SMGStudiosLLC/ASL-Wiz/renders/04_front_elevation.png

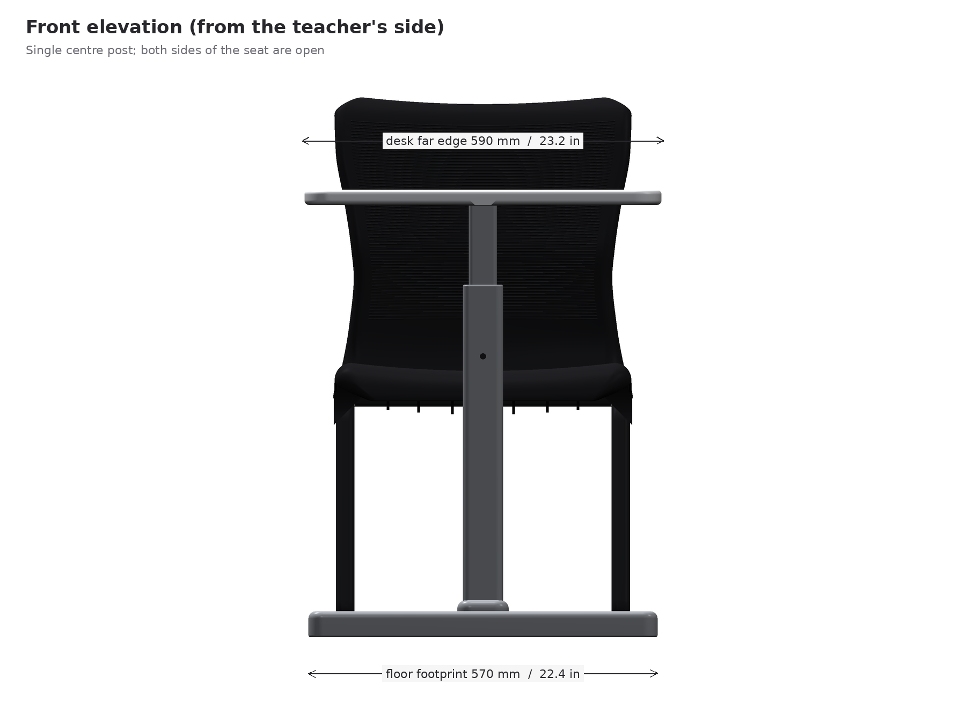
renders/04_front_elevation.png
