SMGStudiosLLC/ASL-Wiz/models/DELTA_chair-desk_full-size.step

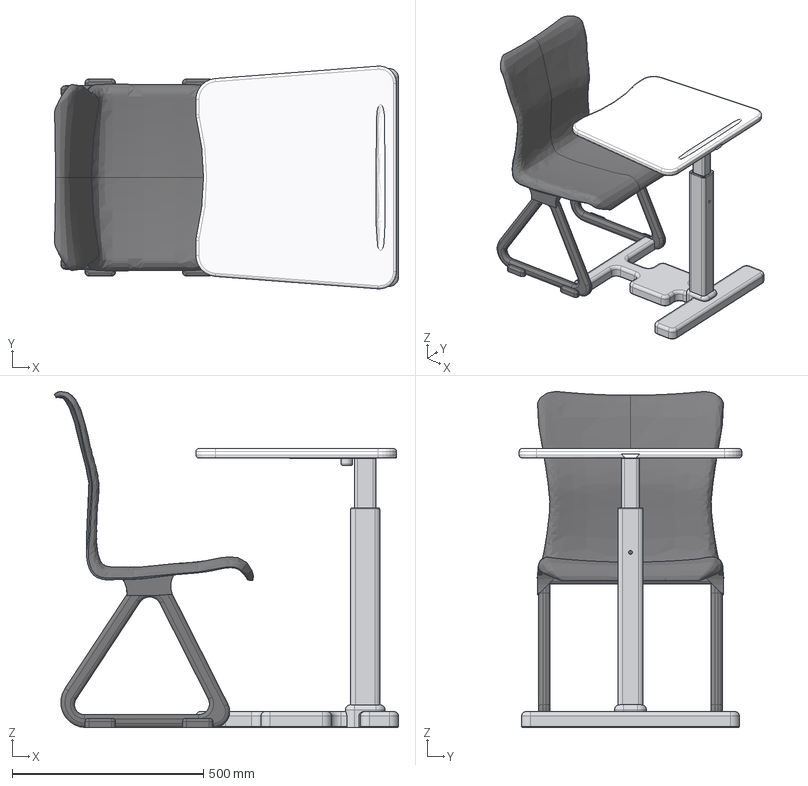
[picture p11: CAD file, 2026-09-27]
models/DELTA_chair-desk_full-size.step
899.8 x 582.6 x 879.4 mm
seat_shell
seat_beam
frame_left
frame_right
floor_base
post_lower_sleeve
post_upper_head
desktop
track_end_plug
