SMGStudiosLLC/ASL-Wiz/models/stl/seat_beam_full-size_mm.stl

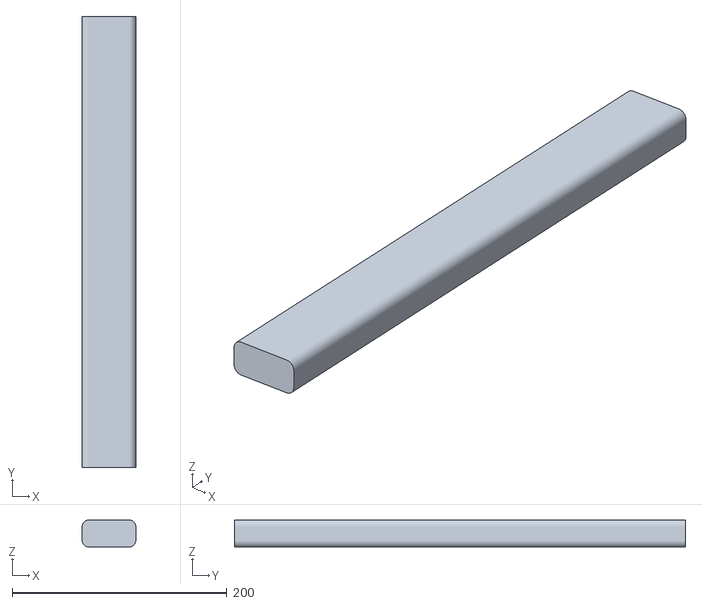
[picture p12: CAD file, 2026-09-27]
models/stl/seat_beam_full-size_mm.stl
50.0 x 420.0 x 25.0
