SMGStudiosLLC/ASL-Wiz/print/DELTA_1-6_assembled_preview.3mf

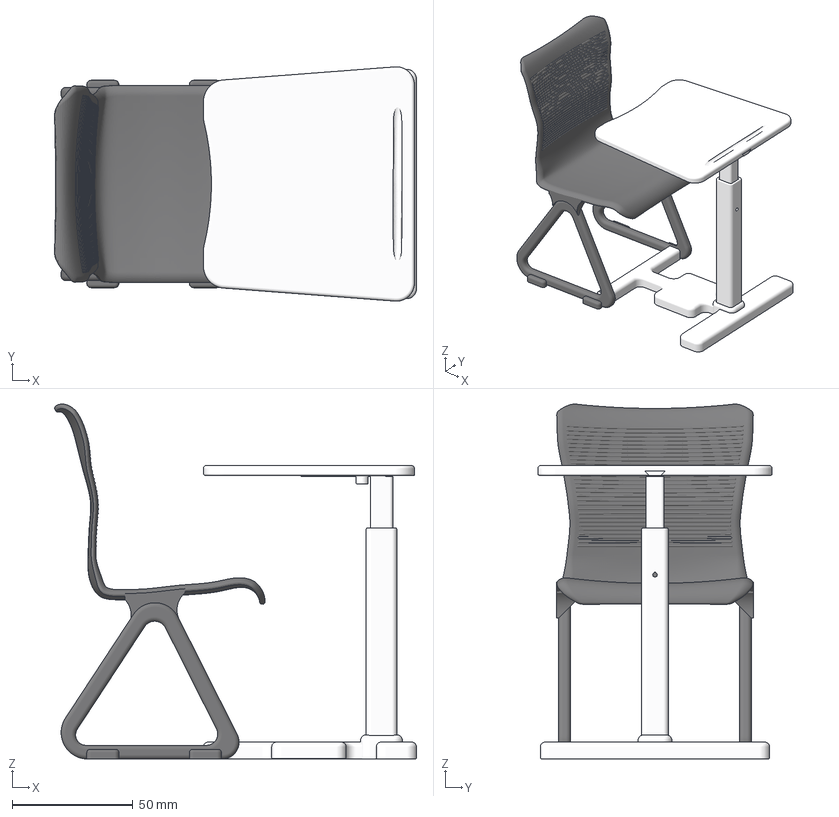
[picture p13: CAD file, 2026-09-27]
print/DELTA_1-6_assembled_preview.3mf
150.0 x 97.1 x 147.1 mm
seat_shell
frame_left
frame_right
floor_base
post_lower_sleeve
post_upper_head
desktop
track_end_plug
