SMGStudiosLLC/ASL-Wiz/models/stl/frame_right_full-size_mm.stl

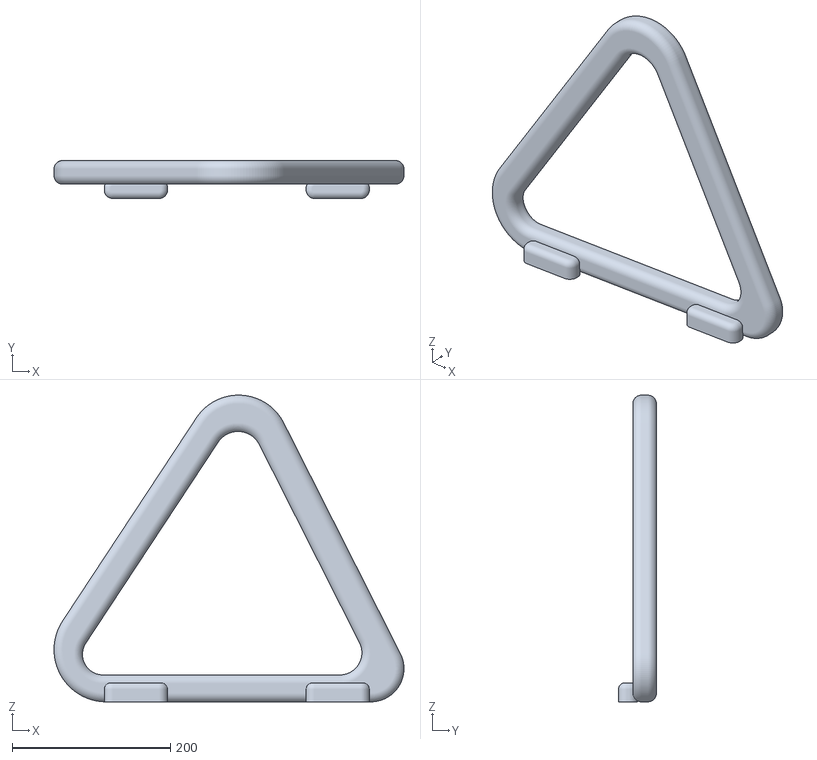
[picture p14: CAD file, 2026-09-27]
models/stl/frame_right_full-size_mm.stl
442.2 x 48.0 x 387.5
