SMGStudiosLLC/ASL-Wiz/models/stl/seat_shell_full-size_mm.stl

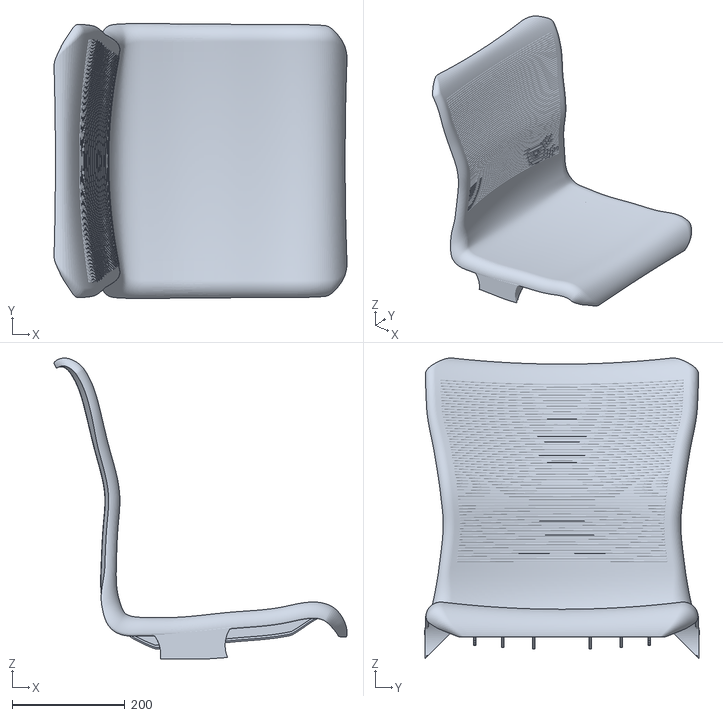
[picture p15: CAD file, 2026-09-27]
models/stl/seat_shell_full-size_mm.stl
520.4 x 489.0 x 534.4
