SMGStudiosLLC/ASL-Wiz/models/stl/desktop_full-size_mm.stl

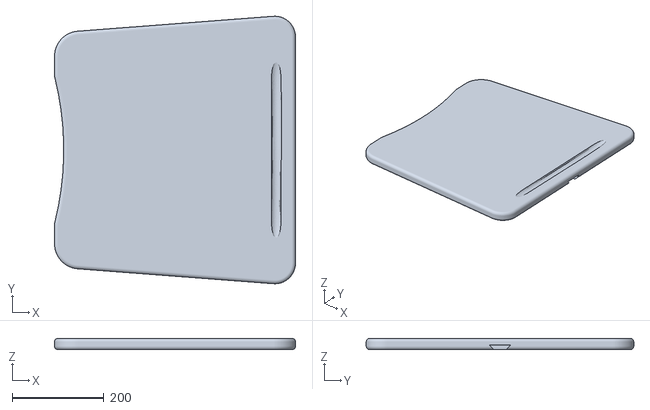
[picture p16: CAD file, 2026-09-27]
models/stl/desktop_full-size_mm.stl
525.0 x 582.9 x 25.0
