SMGStudiosLLC/ASL-Wiz/models/stl/track_end_plug_full-size_mm.stl

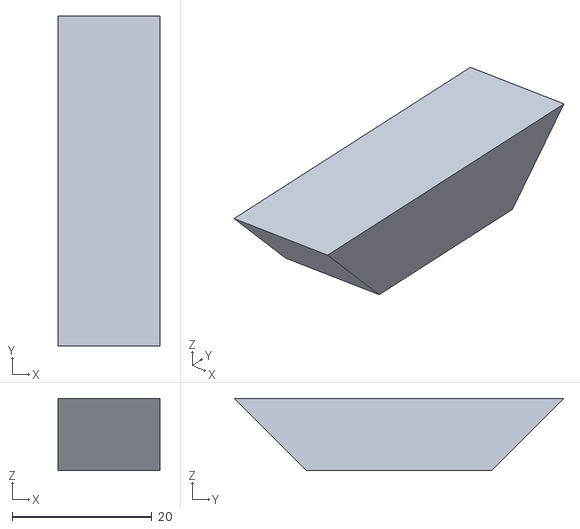
[picture p17: CAD file, 2026-09-27]
models/stl/track_end_plug_full-size_mm.stl
14.6 x 47.2 x 10.3
