SMGStudiosLLC/ASL-Wiz/models/stl/floor_base_full-size_mm.stl

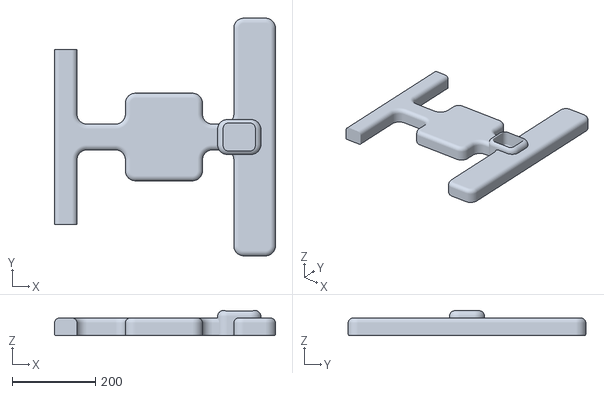
[picture p18: CAD file, 2026-09-27]
models/stl/floor_base_full-size_mm.stl
530.0 x 570.0 x 60.0
