SMGStudiosLLC/ASL-Wiz/models/stl/post_lower_sleeve_full-size_mm.stl

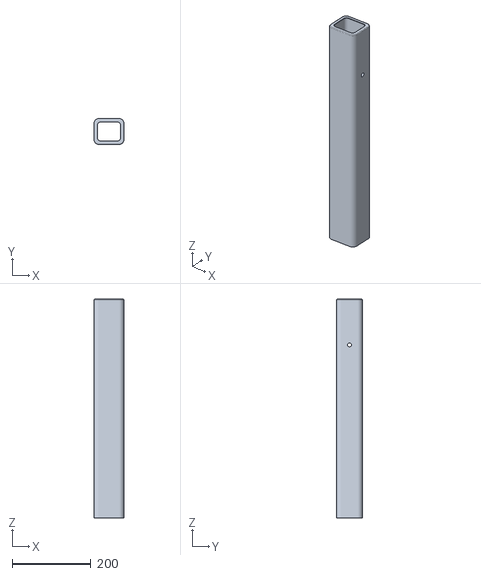
[picture p19: CAD file, 2026-09-27]
models/stl/post_lower_sleeve_full-size_mm.stl
76.0 x 66.0 x 558.0
