SMGStudiosLLC/ASL-Wiz/models/stl/post_upper_head_full-size_mm.stl

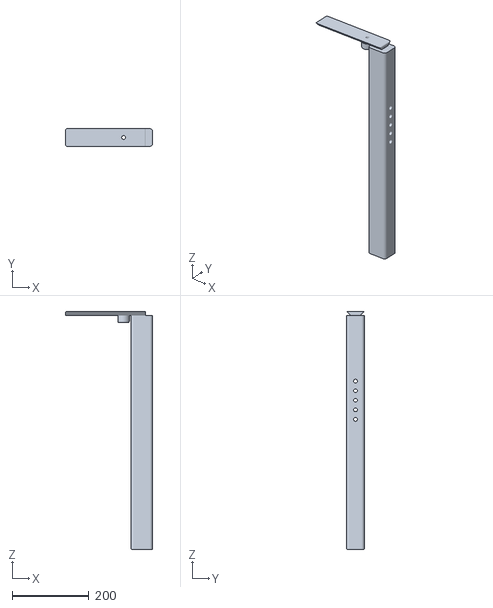
[picture p20: CAD file, 2026-09-27]
models/stl/post_upper_head_full-size_mm.stl
228.0 x 46.0 x 622.0
