SMGStudiosLLC/ASL-Wiz/print/stl/08_track_end_plug_WHITE.stl

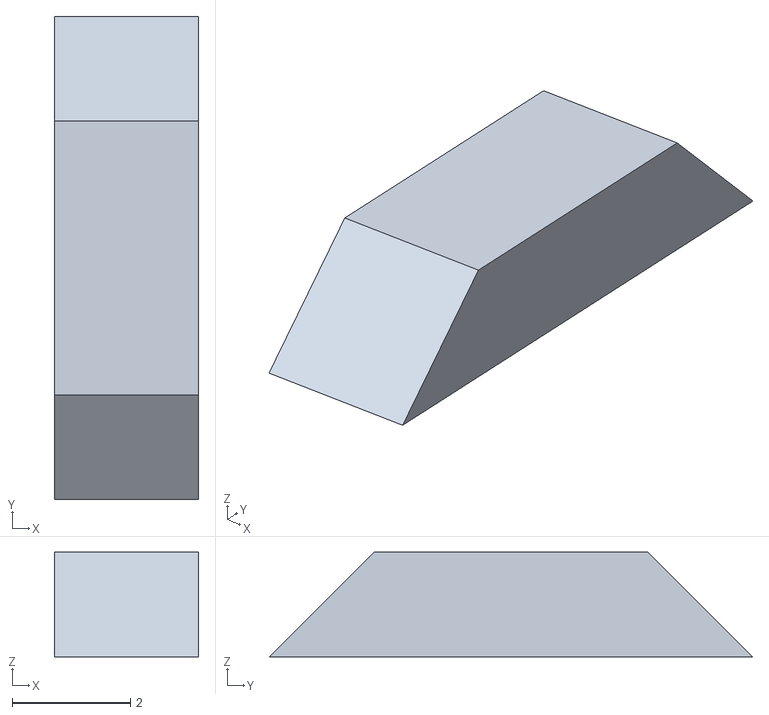
[picture p21: CAD file, 2026-09-27]
print/stl/08_track_end_plug_WHITE.stl
2.43 x 8.17 x 1.77
