SMGStudiosLLC/ASL-Wiz/print/DELTA_1-6_WHITE_plate.3mf

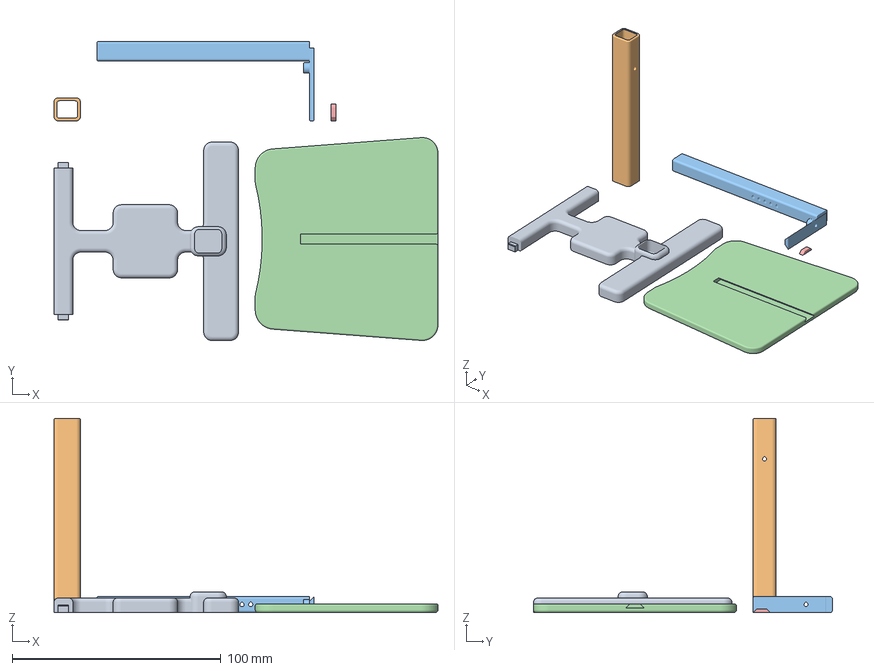
[picture p22: CAD file, 2026-09-27]
print/DELTA_1-6_WHITE_plate.3mf
183.8 x 143.1 x 93.0 mm
floor_base
post_lower_sleeve
post_upper_head
desktop
track_end_plug
