SMGStudiosLLC/ASL-Wiz/print/stl/06_post_upper_head_WHITE.stl

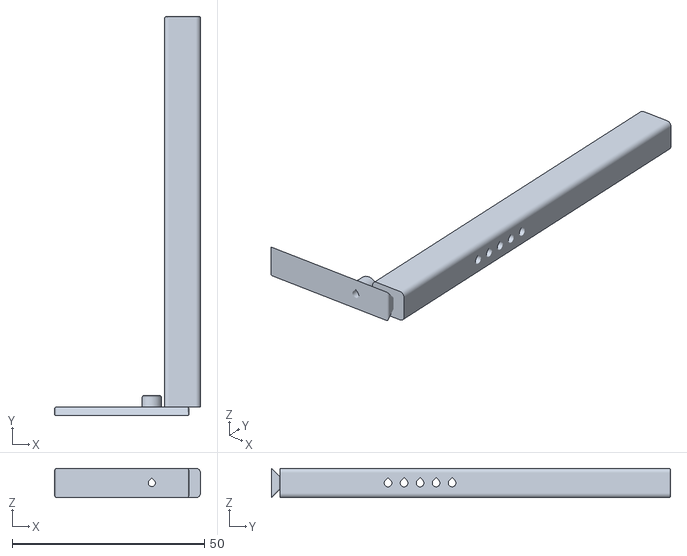
[picture p23: CAD file, 2026-09-27]
print/stl/06_post_upper_head_WHITE.stl
38.0 x 103.8 x 7.67
