SMGStudiosLLC/ASL-Wiz/print/DELTA_1-6_BLACK_plate.3mf

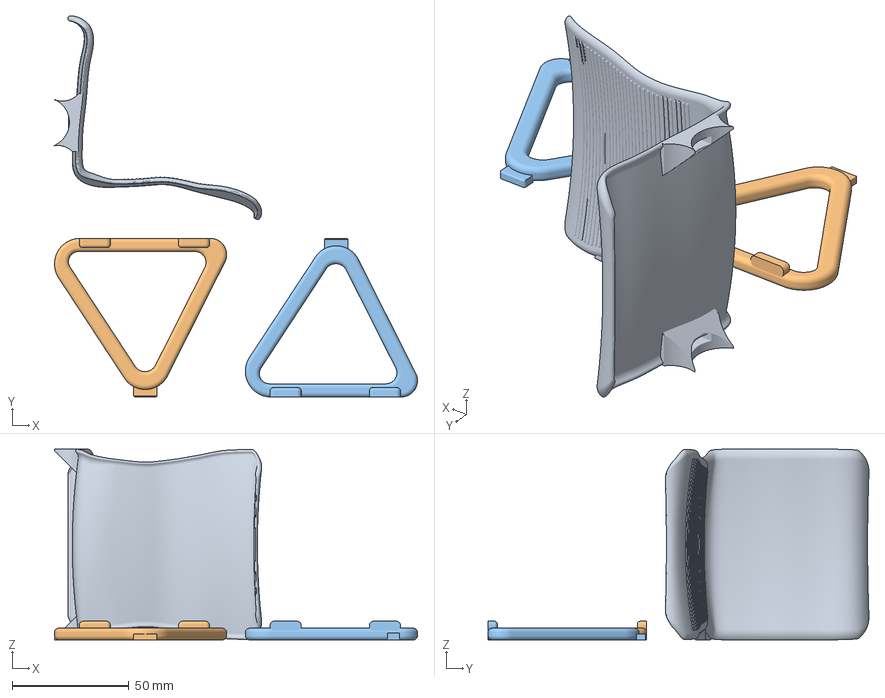
[picture p24: CAD file, 2026-09-27]
print/DELTA_1-6_BLACK_plate.3mf
155.5 x 163.2 x 81.7 mm
seat_shell
frame_left
frame_right
