SMGStudiosLLC/ASL-Wiz/print/stl/07_desktop_WHITE.stl

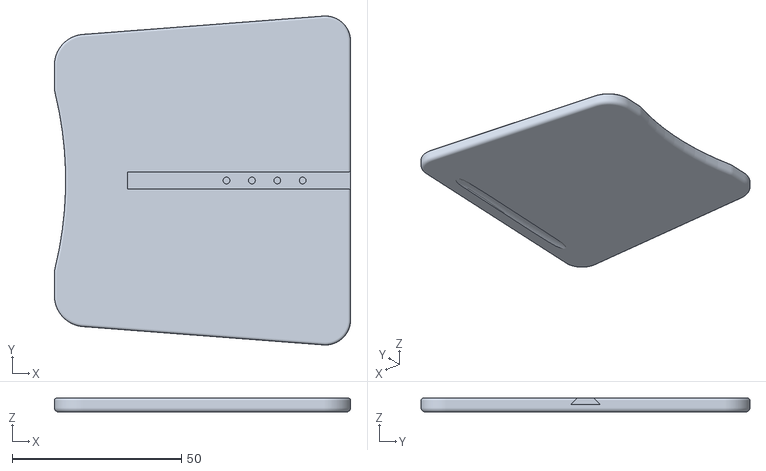
[picture p25: CAD file, 2026-09-27]
print/stl/07_desktop_WHITE.stl
87.5 x 97.1 x 4.17
