SMGStudiosLLC/ASL-Wiz/print/stl/04_floor_base_WHITE.stl

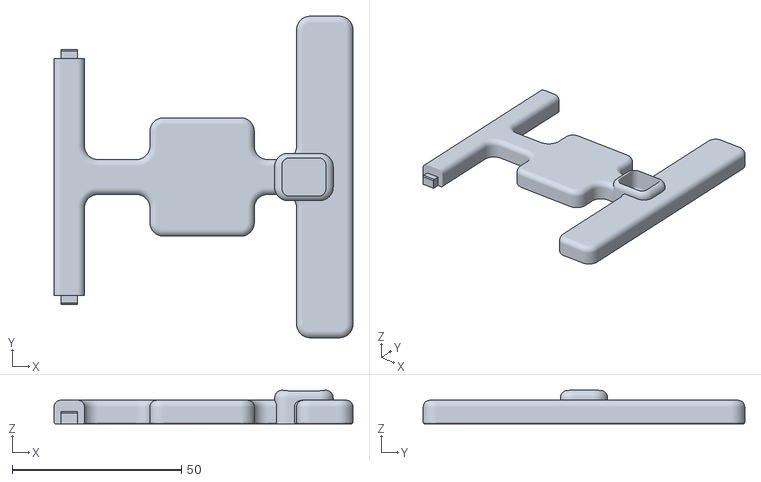
[picture p26: CAD file, 2026-09-27]
print/stl/04_floor_base_WHITE.stl
88.3 x 95.0 x 10.00
