SMGStudiosLLC/ASL-Wiz/print/stl/03_frame_right_BLACK.stl

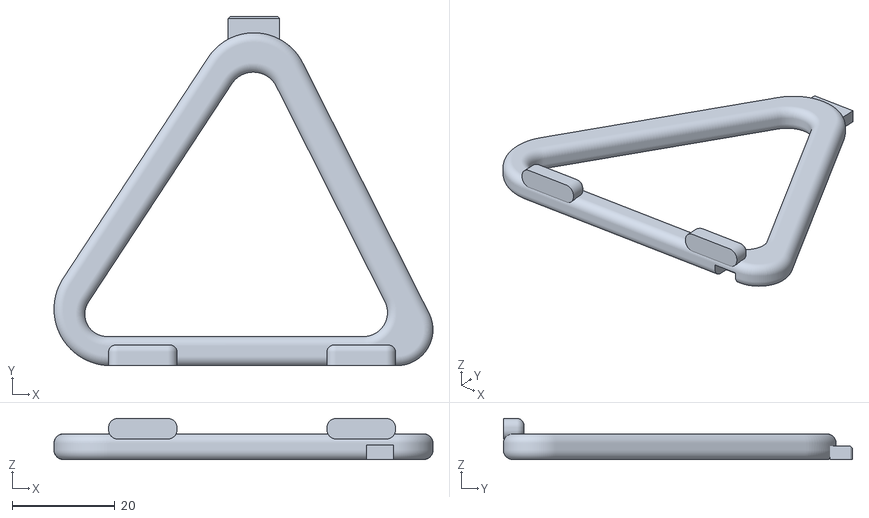
[picture p27: CAD file, 2026-09-27]
print/stl/03_frame_right_BLACK.stl
73.7 x 68.0 x 8.00
