SMGStudiosLLC/ASL-Wiz/print/stl/01_seat_shell_BLACK.stl

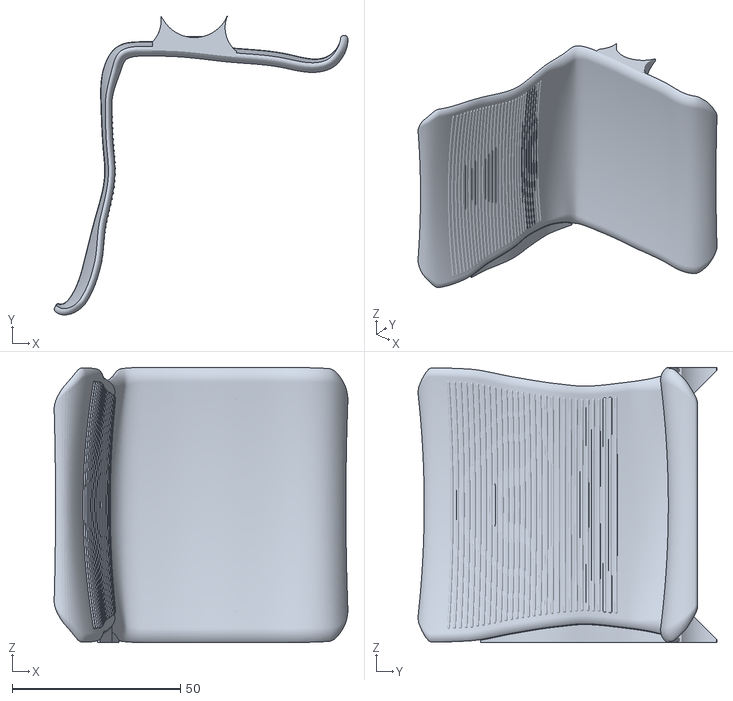
[picture p28: CAD file, 2026-09-27]
print/stl/01_seat_shell_BLACK.stl
87.2 x 88.8 x 81.7
