SMGStudiosLLC/ASL-Wiz/print/stl/05_post_lower_sleeve_WHITE.stl

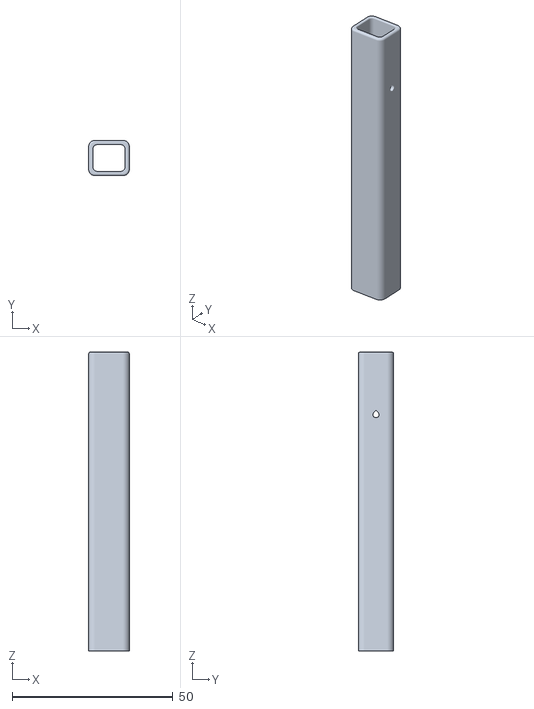
[picture p29: CAD file, 2026-09-27]
print/stl/05_post_lower_sleeve_WHITE.stl
12.7 x 11.0 x 93.0
