SMGStudiosLLC/ASL-Wiz/(list of files, cad)

Other CAD files:
models/stl/frame_left_full-size_mm.stl
print/stl/02_frame_left_BLACK.stl
