SMGStudiosLLC/ASL-Wiz/renders/11_print_plates.png

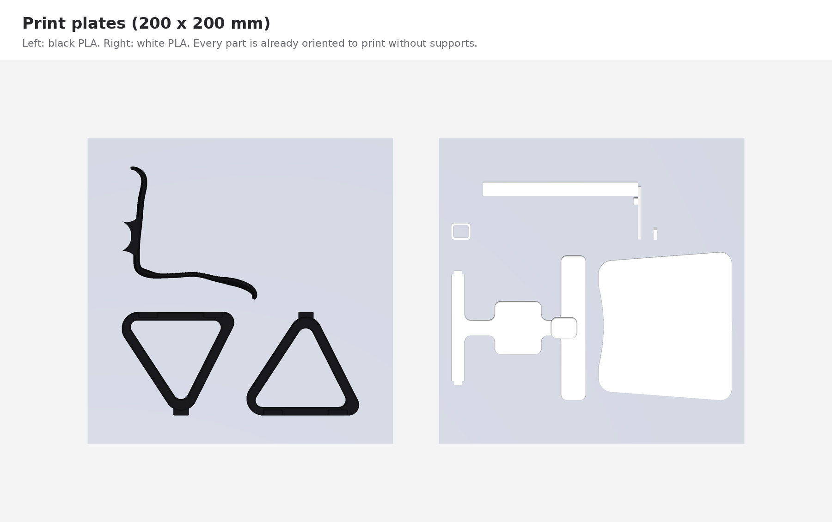
renders/11_print_plates.png
