SMGStudiosLLC/ASL-Wiz/docs/VERIFICATION.md

# Verification report

Generated by `cad/verify_all.py` on 2026-09-27. Every number below is computed from the same geometry that produced the print files.

## 1. Print kit (1:6)

| part | watertight | print size (mm) | solid PLA | bed contact (mm2) | 5th pct wall (mm) | largest >45 deg overhang region |
|---|---|---|---|---|---|---|
| seat_shell | yes | 87 x 89 x 82 | 25.9 g | 199 | 1.25 | 69 mm2, 74 mm span |
| frame_left | yes | 74 x 68 x 8 | 7.8 g | 765 | 4.03 | 88 mm2, 61 mm span |
| frame_right | yes | 74 x 68 x 8 | 7.8 g | 765 | 4.00 | 88 mm2, 61 mm span |
| floor_base | yes | 88 x 95 x 10 | 30.6 g | 3490 | 2.53 | none |
| post_lower_sleeve | yes | 13 x 11 x 93 | 6.3 g | 55 | 1.37 | none |
| post_upper_head | yes | 38 x 104 x 8 | 9.2 g | 774 | 1.57 | 35 mm2, 23 mm span |
| desktop | yes | 88 x 97 x 4 | 39.0 g | 7301 | 2.26 | 203 mm2, 62 mm span |
| track_end_plug | yes | 2 x 8 x 2 | 0.0 g | 20 | 0.34 | none |

Total solid PLA: about 127 g (a real print with 15-20% infill uses less).

How to read the overhang column: what is left is (a) the undersides of small edge fillets right at the bed (they start within half a millimetre of it and print as part of the first layers), (b) flat bridges of about 10 mm or less: the tab sockets in the seat and the pencil groove, which prints face down, and (c) on the seat shell, the underside of its side roll along the bed, up to 6 mm above it at about 65 degrees, which comes out slightly rough. The one stretch that would otherwise hang in the air, the lower edge of the back's waist, prints on a breakaway fin that is part of the shell's file. No slicer supports are needed.

**Assembly interference (parts overlapping each other when assembled):** none

**Clearances at the joints** (closest surface-to-surface distance, assembled; 0 means the faces touch):

| joint | gap (mm) |
|---|---|
| frame tab in seat socket | 0.00 |
| frame on cross-bar tab | 0.00 |
| sleeve in T-foot socket | 0.15 |
| post in sleeve | 0.30 |
| dovetail in track | 0.22 |
| end plug in track | 0.12 |

**Pin alignment (geometry probe along each pin axis):**

| pin | setting | clear through all parts |
|---|---|---|
| height pin | 655 mm | yes |
| height pin | 680 mm | yes |
| height pin | 705 mm | yes |
| height pin | 730 mm | yes |
| height pin | 755 mm | yes |
| reach pin | 230 mm gap | yes |
| reach pin | 275 mm gap | yes |
| reach pin | 320 mm gap | yes |
| reach pin | 365 mm gap | yes |
| dovetail engaged | tenon inside track | yes |

**Fits (per side clearance):** sliding joints (post in sleeve, dovetail) 0.3 mm; press joints (frame tabs in seat pads, cross-bar tabs, sleeve in T-foot, end plug) 0.15 mm. Pins: 1.75 mm filament; free holes 2.0 mm, the sleeve's hole 1.9 mm (grips the height pin) and the head's guide 1.85 mm (holds the reach pin by friction so it can't drop out).

**Flexing back on the model** (1-D beam along the shell, PLA E = 3.2 GPa, push at shoulder-blade height):

| finger push | back tilts | top moves | peak strain |
|---|---|---|---|
| 2 N | 1.2 deg | 0.8 mm | 0.11 % |
| 5 N | 3.1 deg | 2.1 mm | 0.26 % |
| 10 N | 6.2 deg | 4.2 mm | 0.53 % |
| 20 N | 12.4 deg | 8.5 mm | 1.06 % |

PLA tolerates roughly 1.5-2 % strain for repeated flexing, so a firm push (10-20 N) is safe. The shell prints on its side so the bending runs along the printed lines, not across layer joints.

## 2. Full-size product

| part | volume (L) | effective density | mass (kg) | basis |
|---|---|---|---|---|
| seat_shell | 3.50 | 0.905 | 3.17 | PP impact copolymer, solid wall |
| seat_beam | 0.51 | 0.95 | 0.49 | 6063-T6 aluminium tube (2.70), 2.5 mm wall |
| frame_left | 1.34 | 0.75 | 1.00 | PA6-GF30 (1.36) gas-assist hollow, ~55% solid |
| frame_right | 1.34 | 0.75 | 1.00 | PA6-GF30 (1.36) gas-assist hollow, ~55% solid |
| floor_base | 5.32 | 0.81 | 4.31 | cast aluminium (2.70), cored, ~30% solid |
| post_lower_sleeve | 1.20 | 1.0 | 1.20 | 6063-T6 aluminium extrusion, 3 mm wall |
| post_upper_head | 1.61 | 0.9 | 1.45 | cast aluminium head + 3 mm wall inner tube |
| desktop | 6.81 | 0.8 | 5.45 | moulded solid-core top / HPL on particleboard |
| track_end_plug | 0.01 | 1.1 | 0.01 | moulded end cap |

**Total about 18.1 kg (40 lb)**, centre of gravity at X = 459 mm, Z = 389 mm. For comparison the Virco 3700BRM is listed at 35-45 lb.

**Assembly interference (full size):** none

### Tipping (rigid-body statics about the edges of the floor footprint)

| load case | result | target |  |
|---|---|---|---|
| Rear: 81.6 kg on the seat + push backward at the top of the back (BIFMA-style) | tips at 278 N | needs 147 N (X5.1 formula) | PASS |
| Rear: 181 kg (400 lb) student leaning back + 250 N push with the feet | margin 1.54 | > 1.0 | PASS |
| Rear: empty chair, someone presses straight down on the top of the backrest | tips at 169 kg | > 50 kg | PASS |
| Forward: someone sits on the far desk corner, empty seat, reach 230 | does not tip | > 100 kg | PASS |
| Forward: someone sits on the far desk corner, empty seat, reach 275 | does not tip | > 100 kg | PASS |
| Forward: someone sits on the far desk corner, empty seat, reach 320 | does not tip | > 100 kg | PASS |
| Forward: someone sits on the far desk corner, empty seat, reach 365 | tips at 127 kg | > 100 kg | PASS |
| Sideways: leaning on the near desk corner, empty seat (worst reach) | does not tip | > 100 kg | PASS |
| Sideways: sitting on the very edge of the seat | does not tip | - | PASS |
| Sideways: 600 N down near the seat's side edge + 20 N outward (the EN 1022 sideways test loads) | margin 8.8 | > 1.0 | PASS |
| Sideways: student leans out to pick a bag off the floor (80-181 kg, feet lifted, worst case) | margin 1.42 | > 1.0 | PASS |

"Feet lifted" in the last row means the student's whole weight is on the chair, which is the worst case; in practice a foot on the floor takes part of it. The glide pods on the outside of each frame's feet widen the footprint to 516 mm at the seat, which is what keeps the sideways cases safe.

### Strength (hand calculations)

| case | load | result | reference |
|---|---|---|---|
| Post: 100 kg on the near desk edge, nearest reach | 488 N m | sleeve 26.5 MPa, inner 53.3 MPa | 6063-T6 yield 214 MPa |
| Seat front: 1000 N on the front edge | 185 N m | 13.9 MPa | PP copolymer yield ~25-30 MPa |
| Back: 150 N at shoulder-blade height (casual lean) | back tilts 3.5 deg | 5.5 MPa at Z=405 | PP E = 1.3 GPa (linear model) |
| Back: 250 N at shoulder-blade height (firm lean) | back tilts 5.9 deg | 9.2 MPa at Z=405 | PP E = 1.3 GPa (linear model) |
| Back: 1000 N at shoulder-blade height (BIFMA X6.1 back functional load) | back tilts 23.4 deg | 36.8 MPa at Z=405 | PP E = 1.3 GPa (linear model) |

The backrest is designed to give a few degrees under a casual lean and about twice that under a firm one. Under the 1000 N BIFMA back test, the linear estimate exceeds the yield strength of unfilled polypropylene, so a production shell should use a 20 % talc- or glass-filled PP in the junction (or be tuned with FEA) and be proven by a physical BIFMA X6.1 test. This is normal for moulded school chairs.

### Ergonomic fit (ANSUR II adult data as the proxy for high-schoolers; see RESEARCH.md)

The reach setting is the first one that leaves 3 cm between belly and desk, measured at the middle of the desk's curved near edge.

| student | seat height vs knee height (+ = too high) | seat depth / thigh length | seat width vs hips | best desk height | desk heights with thigh room | reach setting |
|---|---|---|---|---|---|---|
| F5 | +55 mm (+13 on the spine) | 91 % | +169 mm | 655 mm | 655, 680, 705, 730, 755 | 250 mm |
| F50 | +18 mm | 83 % | +127 mm | 680 mm | 655, 680, 705, 730, 755 | 295 mm |
| M50 | -25 mm | 80 % | +136 mm | 680 mm | 655, 680, 705, 730, 755 | 295 mm |
| M95 | -66 mm | 73 % | +93 mm | 730 mm | 680, 705, 730, 755 | 385 mm |
| Large | -15 mm | 77 % | -65 mm | 705 mm | 705, 730, 755 | 385 mm + back flex |

Reading the table: seat depth should stay under 95 % of thigh length (it does for everyone). A seat that is too high presses on the underside of the thigh; the 5th percentile student rests her feet on the 42 mm spine and the mismatch drops to about 1 cm. Larger-bodied students are wider than any school seat; the open sides (no side bar, no arms) let them sit comfortably anyway.

## 3. Known limitations

- Anthropometry uses adult US Army data (ANSUR II) as a stand-in; the new YouthShape.US teen survey was not published yet.
- Strength and stiffness numbers come from hand calculations (1-D beams, rigid-body tipping), not FEA. They are good for catching bad ideas early, not for certifying a product.
- The PLA model is a demonstration: it flexes, slides and adjusts like the real design, but PLA fatigues much sooner than polypropylene.
