SMGStudiosLLC/ASL-Wiz/(commit log)

2026-09-27 Replace ASL site with DELTA chair-desk redesign: parametric CAD, 1:6 print kit, full-size models
    Parametric CadQuery generator for a school chair-desk redesign (Virco 3700BRM
    replacement concept): one-piece flexing shell with grip ribs, two rounded-
    triangle side frames, low centre spine with T-foot, telescoping post and a
    sliding desktop. Builds a support-free 1:6 PLA kit (STL + 3MF plates) and
    full-size GLB/USDZ/STL.
    Claude-Session: https://claude.ai/code/session_016NJYY16WmUkQUMQiCXuHTS
    [01_seat_shell_BLACK.stl, 02_frame_left_BLACK.stl, 03_frame_right_BLACK.stl, 04_floor_base_WHITE.stl, 05_post_lower_sleeve_WHITE.stl, 06_post_upper_head_WHITE.stl, 07_desktop_WHITE.stl, DELTA_1-6_BLACK_plate.3mf]
2026-09-27 Apply design review fixes, add fourth reach setting, regenerate all outputs
    - Desk head: dovetail tenon now sits inside the desktop track; end plug
    closes the track so the desktop cannot slide off, twist or detach
    - Base rewritten: square cross-bar ends, footrest pad, 570 mm T-foot,
    rounded socket boss; post bottoms out at the lowest setting
    - Frames: glide pods widen the footprint for sideways sitting; hidden
    seat beam ties the frames under the seat (full-size model)
    - Four reach settings (230/275/320/365 mm) so larger students fit
    - Print kit: 8 parts, breakaway support fin on the shell, looser fits,
    pin holes that grip the pins, plate packer keeps parts on the bed
    - Verification: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
    [01_seat_shell_BLACK.stl, 02_frame_left_BLACK.stl, 03_frame_right_BLACK.stl, 04_floor_base_WHITE.stl, 05_post_lower_sleeve_WHITE.stl, 06_post_upper_head_WHITE.stl, 07_desktop_WHITE.stl, 08_track_end_plug_WHITE.stl]
2026-09-27 Add exact full-size STEP; make the shell B-rep export-safe
    - Shell loft uses one shared spline parametrisation for all rings, which
    shrinks the surface from 32 MB to under 1 MB with the same shape
    - The loft's closed side face is split so it survives a STEP round trip
    - STEP seat shell = shell + two bearing pads as touching solids, since
    OpenCASCADE booleans against the loft were unreliable; pads stop at
    the shell's underside and stay out of the curled side edges
    - STEP holds 11 valid solids (7 MB)
    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
    [DELTA_1-6_BLACK_plate.3mf, DELTA_1-6_WHITE_plate.3mf, DELTA_1-6_assembled_preview.3mf, DELTA_chair-desk_full-size.step]
2026-09-27 Add a SketchUp-ready COLLADA export of the full-size model
    The SketchUp connector's live session reset partway through building a
    .skp, so the model now ships as a .dae that SketchUp imports directly:
    millimetres, Z up, one named and coloured group per part, meshes
    decimated to about 105k triangles so SketchUp stays responsive.
    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
    [DELTA_1-6_BLACK_plate.3mf, DELTA_1-6_WHITE_plate.3mf, DELTA_1-6_assembled_preview.3mf]
